amandapdb/BotStock/BotStock_GRBL/Configuracao_GRBL.png

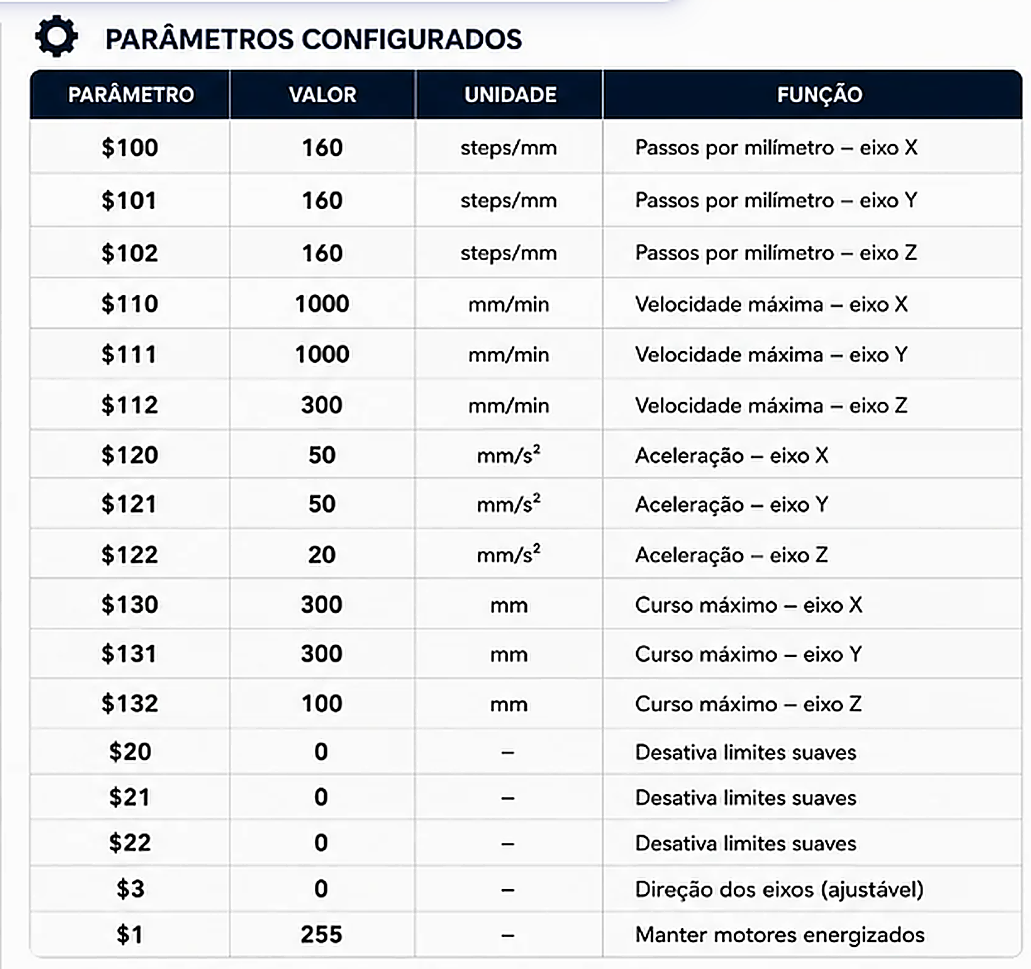
BotStock_GRBL/Configuracao_GRBL.png
