amandapdb/BotStock/BotStock_VSCode/eye_close.png

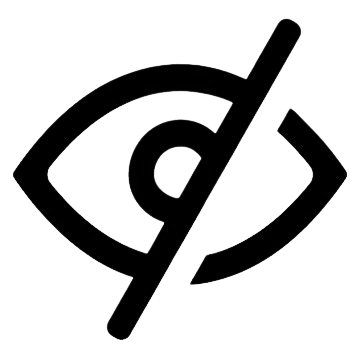
BotStock_VSCode/eye_close.png
