amandapdb/BotStock/BotStock_VSCode/eye_open.png

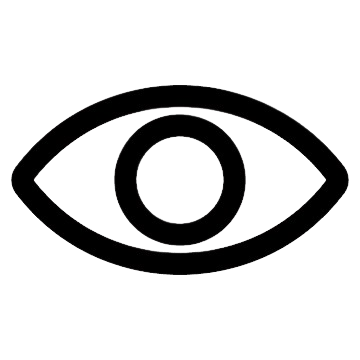
BotStock_VSCode/eye_open.png
