amandapdb/BotStock/(commit log)

2026-06-07 Add files via upload
    Banco de Dados do projeto.
2026-06-07 Add files via upload
    Programação do Arduino do projeto.
2026-06-07 Add files via upload
    Configurações GRBL do projeto
